mahmoudnazih/bldc-hardware/design/BLDC_4.kicad_sch

## KiCad design design/BLDC_4.kicad_sch (2024-09-17)

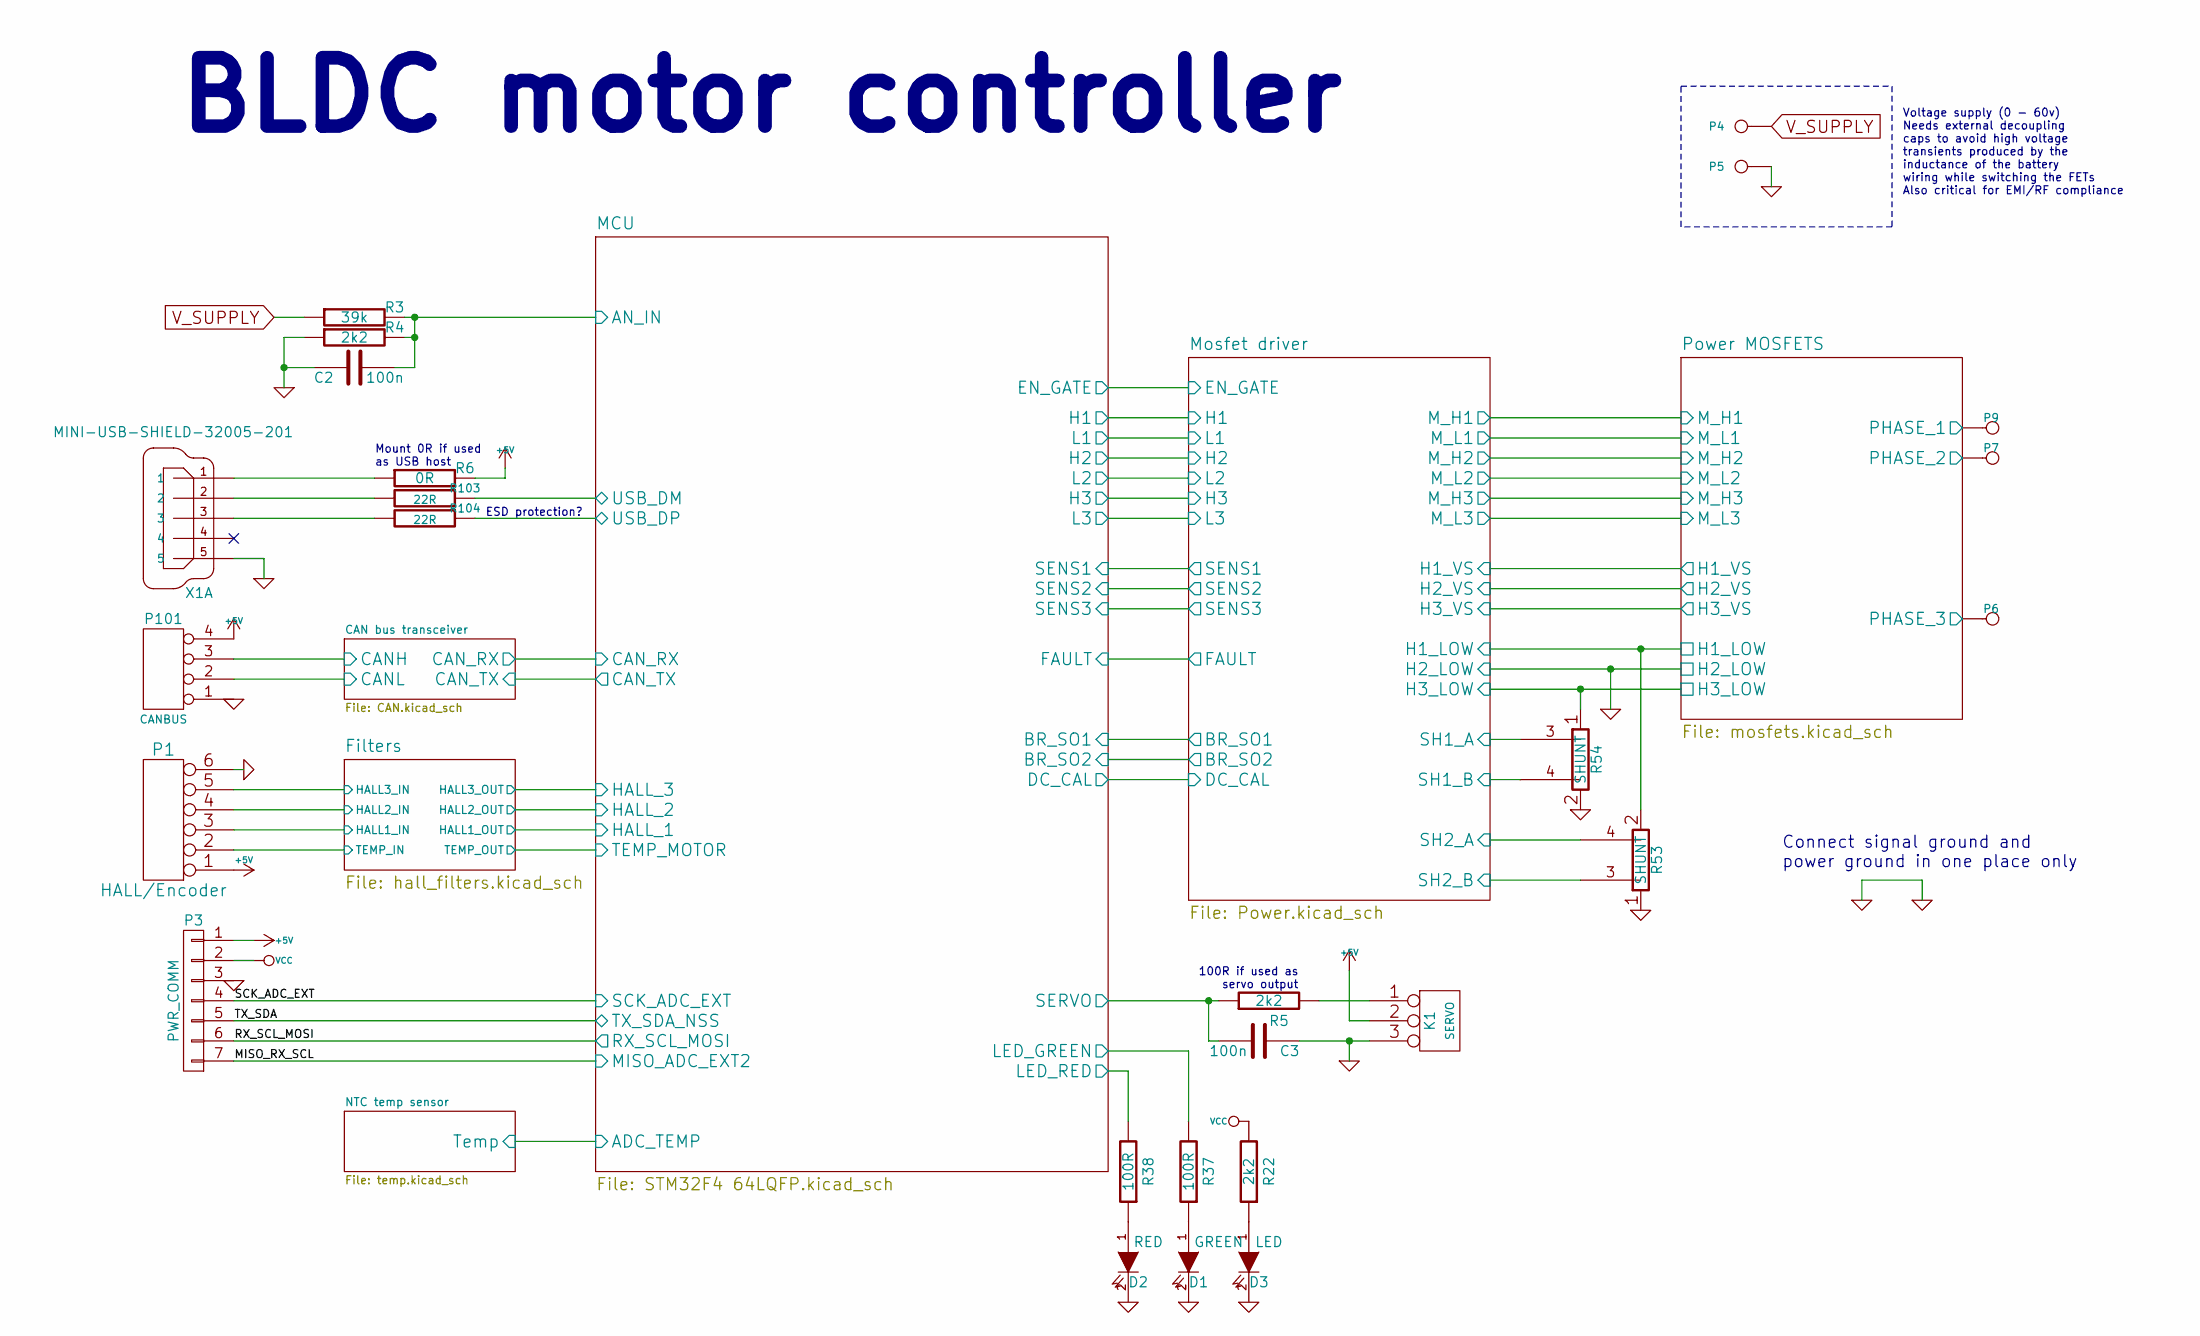
[picture p1: schematic BLDC_4.kicad_sch]

Parts:
C2, C3: 100n; SMD-0603_c
D1: GREEN; LED-0603
D2: RED; LED-0603
D3: LED; LED-0603
K1: SERVO; pinhead-1X03
P1: HALL/Encoder; MICRO_JST_6
P3: PWR_COMM; b7b-ph-kl
P4: IN+; 1PAD_4x5mm
P5: IN-; 1PAD_4x5mm
P6: MOTOR1; 1PAD_4x5mm
P7: MOTOR2; 1PAD_4x5mm
P9: MOTOR3; 1PAD_4x5mm
P101: CANBUS; b4b-ph-kl
R3: 39k; SMD-0603_r
R4, R5, R22: 2k2; SMD-0603_r
R6: 0R; SMD-0603_r
R37, R38: 100R; SMD-0603_r
R53, R54: SHUNT; WSLP2726
R103, R104: 22R; SMD-0603_r
X1: MINI-USB-SHIELD-32005-201; USB-UX60R-MB-5ST

Connections:
+5V: K1.2 (PM), P1.1, P3.1, P101.4, R6.2
AN_IN: C2.2, R3.2, R4.2
CANH: P101.3
CANL: P101.2
GND: C2.1, C3.1, D1.2 (K), D2.2 (K), D3.2 (K), K1.3, P1.6, P3.3, P5.1, P101.1, R4.1, R53.1, R54.2, X1.5
H1_LOW: R53.2
H3_LOW: R54.1
HALL1_IN: P1.3
HALL2_IN: P1.4
HALL3_IN: P1.5
LED_GREEN: R37.2
LED_RED: R38.2
MISO_RX_SCL: P3.7
unnamed: D1.1 (A), R37.1
unnamed: D2.1 (A), R38.1
unnamed: D3.1 (A), R22.1
unnamed: K1.1, R5.2
unnamed: R6.1, X1.1
unnamed: R103.2, X1.2
unnamed: R104.2, X1.3
PHASE_1: P9.1
PHASE_2: P7.1
PHASE_3: P6.1
RX_SCL_MOSI: P3.6
SCK_ADC_EXT: P3.4
SERVO: C3.2, R5.1
SH1_A: R54.3
SH1_B: R54.4
SH2_A: R53.4
SH2_B: R53.3
TEMP_IN: P1.2
TX_SDA: P3.5
USB_DM: R103.1
USB_DP: R104.1
VCC: P3.2, R22.2
V_SUPPLY: P4.1, R3.1

Notes on the sheet:
ESD protection?
Connect signal ground and power ground in one place only
Voltage supply (0 - 60v) Needs external decoupling caps to avoid high voltage transients produced by the inductance of the battery wiring while switching the FETs Also critical for EMI/RF compliance
BLDC motor controller
Mount 0R if used as USB host
100R if used as servo output
