mahmoudnazih/bldc-hardware/design/CAN.kicad_sch

## KiCad design design/CAN.kicad_sch (2024-09-17)

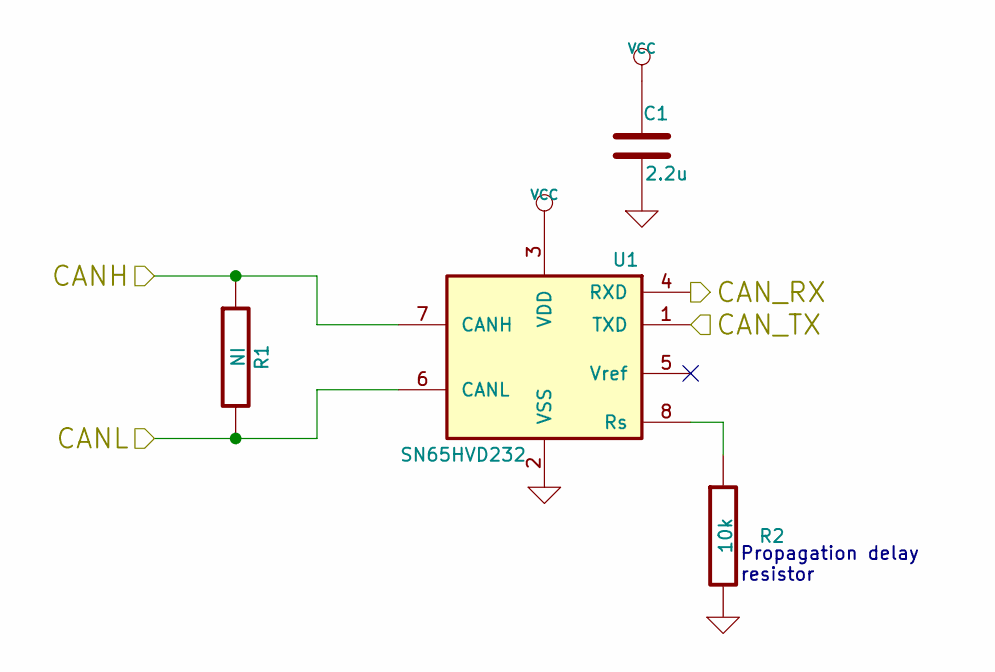
[picture p2: schematic CAN.kicad_sch]

Parts:
C1: 2.2u; SMD-0603_c
R1: NI; SMD-0603_r
R2: 10k; SMD-0603_r
U1: SN65HVD232; SOIC-8-W

Connections:
CANH: R1.1, U1.7 (CANH)
CANL: R1.2, U1.6 (CANL)
CAN_RX: U1.4 (RXD)
CAN_TX: U1.1 (TXD)
GND: C1.2, R2.2, U1.2 (VSS)
unnamed: R2.1, U1.8 (Rs)
VCC: C1.1, U1.3 (VDD)

Notes on the sheet:
Propagation delay resistor
