mahmoudnazih/bldc-hardware/design/Power.kicad_sch

## KiCad design design/Power.kicad_sch (2024-09-17)

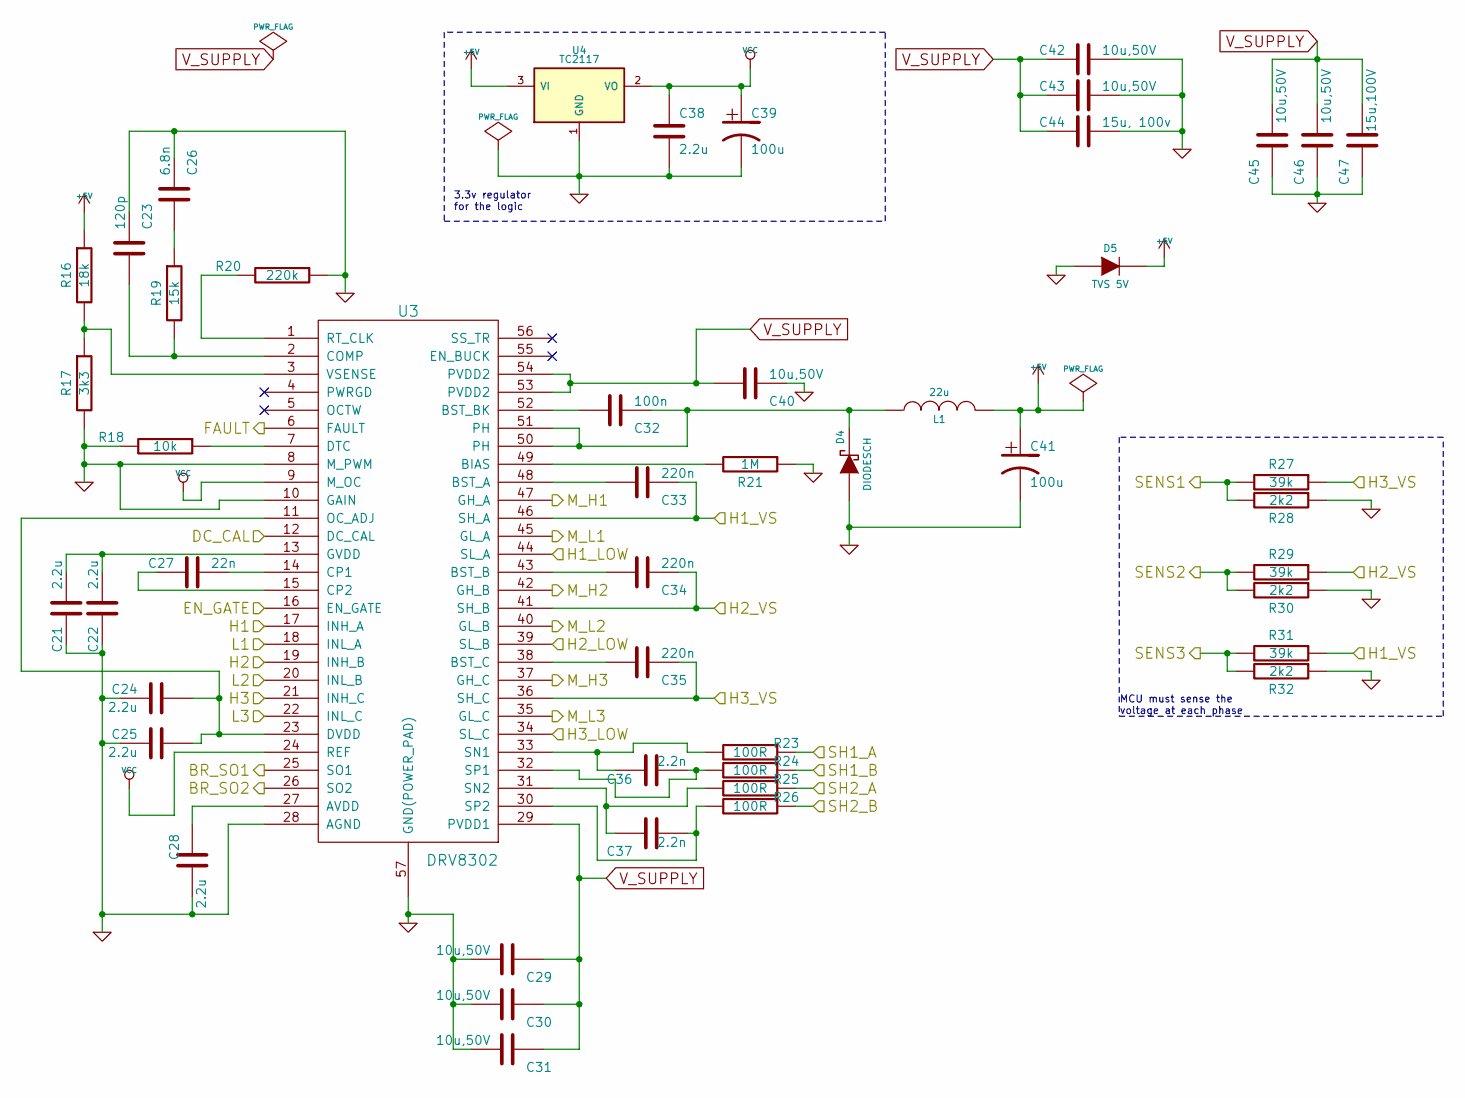
[picture p3: schematic Power.kicad_sch]

Parts:
C21, C22, C24, C25, C28, C38: 2.2u; SMD-0603_c
C23: 120p; SMD-0603_c
C26: 6.8n; SMD-0603_c
C27: 22n; SMD-0603_c
C29, C30, C31, C40, C42, C43, C45, C46: 10u,50V; SMD-1206
C32: 100n; SMD-0603_c
C33, C34, C35: 220n; SMD-0603_c
C36, C37: 2.2n; SMD-0603_c
C39, C41: 100u; c_tant_B
C44: 15u, 100v; c_2220
C47: 15u,100V; c_2220
D4: DIODESCH; SMA_Handsoldering
D5: TVS 5V; do214ac
L1: 22u; inductor_smd_8x5mm
R16: 18k; SMD-0603_r
R17: 3k3; SMD-0603_r
R18: 10k; SMD-0603_r
R19: 15k; SMD-0603_r
R20: 220k; SMD-0603_r
R21: 1M; SMD-0603_r
R23, R24, R25, R26: 100R; SMD-0603_r
R27, R29, R31: 39k; SMD-0603_r
R28, R30, R32: 2k2; SMD-0603_r
U3: DRV8302; TSSOP-56-PP
U4: TC2117; SOT-223

Connections:
+5V: C41.1, D5.2 (K), L1.2, R16.1, U4.3 (VI)
BR_SO1: U3.25 (SO1)
BR_SO2: U3.26 (SO2)
DC_CAL: U3.12 (DC_CAL)
EN_GATE: U3.16 (EN_GATE)
FAULT: U3.6 (FAULT)
GND: C21.2, C22.2, C23.1, C24.1, C25.1, C26.1, C28.1, C29.2, C30.2, C31.2, C38.2, C39.2, C40.1, C41.2, C42.1, C43.1, C44.1, C45.1, C46.1, C47.1, D4.1 (A), D5.1 (A), R17.2, R18.2, R20.1, R21.1, R28.1, R30.1, R32.1, U3.8 (M_PWM), U3.10 (GAIN), U3.28 (AGND), U3.57 (GND(POWER_PAD)), U4.1 (GND)
H1: U3.17 (INH_A)
H1_LOW: U3.44 (SL_A)
H1_VS: C33.1, R31.1, U3.46 (SH_A)
H2: U3.19 (INH_B)
H2_LOW: U3.39 (SL_B)
H2_VS: C34.1, R29.1, U3.41 (SH_B)
H3: U3.21 (INH_C)
H3_LOW: U3.34 (SL_C)
H3_VS: C35.1, R27.1, U3.36 (SH_C)
L1: U3.18 (INL_A)
L2: U3.20 (INL_B)
L3: U3.22 (INL_C)
M_H1: U3.47 (GH_A)
M_H2: U3.42 (GH_B)
M_H3: U3.37 (GH_C)
M_L1: U3.45 (GL_A)
M_L2: U3.40 (GL_B)
M_L3: U3.35 (GL_C)
unnamed: C21.1, C22.1, U3.13 (GVDD)
unnamed: C23.2, R19.2, U3.2 (COMP)
unnamed: C24.2, C25.2, U3.11 (OC_ADJ), U3.23 (DVDD)
unnamed: C26.2, R19.1
unnamed: C27.1, U3.14 (CP1)
unnamed: C27.2, U3.15 (CP2)
unnamed: C28.2, U3.27 (AVDD)
unnamed: C32.1, D4.2 (K), L1.1, U3.50 (PH), U3.51 (PH)
unnamed: C32.2, U3.52 (BST_BK)
unnamed: C33.2, U3.48 (BST_A)
unnamed: C34.2, U3.43 (BST_B)
unnamed: C35.2, U3.38 (BST_C)
unnamed: C36.1, R23.2, U3.33 (SN1)
unnamed: C36.2, R24.2, U3.32 (SP1)
unnamed: C37.1, R25.2, U3.31 (SN2)
unnamed: C37.2, R26.2, U3.30 (SP2)
unnamed: R16.2, R17.1, U3.3 (VSENSE)
unnamed: R18.1, U3.7 (DTC)
unnamed: R20.2, U3.1 (RT_CLK)
unnamed: R21.2, U3.49 (BIAS)
SENS1: R27.2, R28.2
SENS2: R29.2, R30.2
SENS3: R31.2, R32.2
SH1_A: R23.1
SH1_B: R24.1
SH2_A: R25.1
SH2_B: R26.1
VCC: C38.1, C39.1, U3.9 (M_OC), U3.24 (REF), U4.2 (VO)
V_SUPPLY: C29.1, C30.1, C31.1, C40.2, C42.2, C43.2, C44.2, C45.2, C46.2, C47.2, U3.29 (PVDD1), U3.53 (PVDD2), U3.54 (PVDD2)

Notes on the sheet:
3.3v regulator for the logic
MCU must sense the voltage at each phase
