mahmoudnazih/bldc-hardware/design/STM32F4 64LQFP.kicad_sch

## KiCad design design/STM32F4 64LQFP.kicad_sch (2024-09-17)

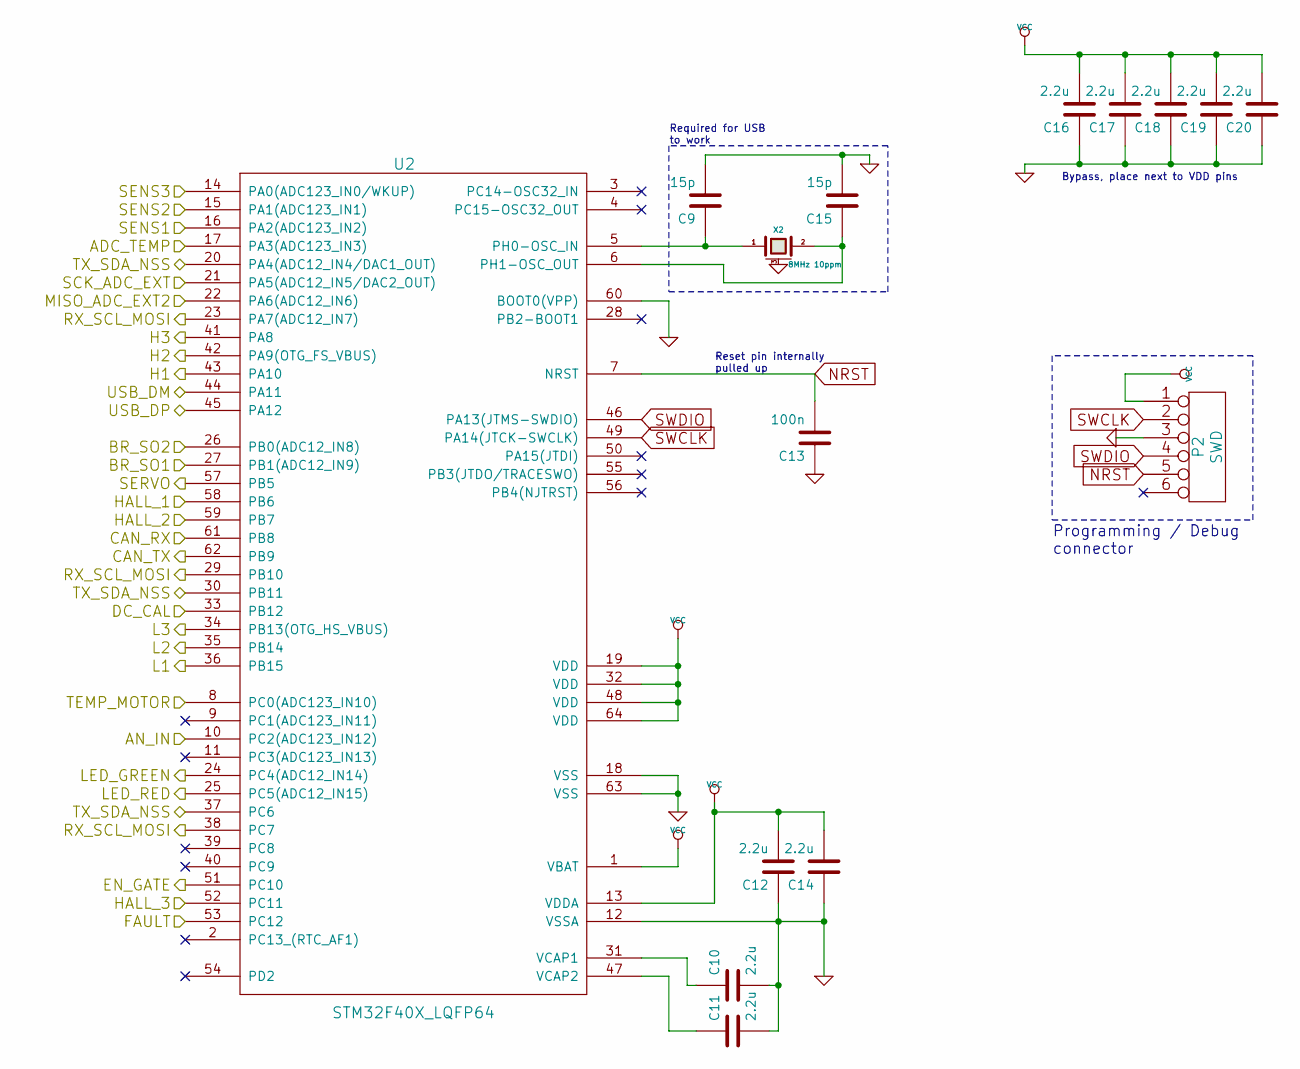
[picture p4: schematic STM32F4 64LQFP.kicad_sch]

Parts:
C9, C15: 15p; SMD-0603_c
C10, C11, C12, C14, C16, C17, C18, C19, C20: 2.2u; SMD-0603_c
C13: 100n; SMD-0603_c
P2: SWD; MICRO_JST_6
U2: STM32F40X_LQFP64; lqfp64_pad_mod
X2: 8MHz 10ppm; Crystal_5x3mm; mfg# ABM3B-8.0-10-1UT

Connections:
ADC_TEMP: U2.17 (PA3(ADC123_IN3))
AN_IN: U2.10 (PC2(ADC123_IN12))
BR_SO1: U2.27 (PB1(ADC12_IN9))
BR_SO2: U2.26 (PB0(ADC12_IN8))
CAN_RX: U2.61 (PB8)
CAN_TX: U2.62 (PB9)
DC_CAL: U2.33 (PB12)
EN_GATE: U2.51 (PC10)
FAULT: U2.53 (PC12)
GND: C9.2, C10.2, C11.2, C12.1, C13.1, C14.1, C15.2, C16.1, C17.1, C18.1, C19.1, C20.1, P2.3, U2.12 (VSSA), U2.18 (VSS), U2.60 (BOOT0(VPP)), U2.63 (VSS), X2.3 (case)
H1: U2.43 (PA10)
H2: U2.42 (PA9(OTG_FS_VBUS))
H3: U2.41 (PA8)
HALL_1: U2.58 (PB6)
HALL_2: U2.59 (PB7)
HALL_3: U2.52 (PC11)
L1: U2.36 (PB15)
L2: U2.35 (PB14)
L3: U2.34 (PB13(OTG_HS_VBUS))
LED_GREEN: U2.24 (PC4(ADC12_IN14))
LED_RED: U2.25 (PC5(ADC12_IN15))
MISO_ADC_EXT2: U2.22 (PA6(ADC12_IN6))
NRST: C13.2, P2.5, U2.7 (NRST)
unnamed: C9.1, U2.5 (PH0-OSC_IN), X2.1
unnamed: C10.1, U2.31 (VCAP1)
unnamed: C11.1, U2.47 (VCAP2)
unnamed: C15.1, U2.6 (PH1-OSC_OUT), X2.2
RX_SCL_MOSI: U2.23 (PA7(ADC12_IN7)), U2.29 (PB10), U2.38 (PC7)
SCK_ADC_EXT: U2.21 (PA5(ADC12_IN5/DAC2_OUT))
SENS1: U2.16 (PA2(ADC123_IN2))
SENS2: U2.15 (PA1(ADC123_IN1))
SENS3: U2.14 (PA0(ADC123_IN0/WKUP))
SERVO: U2.57 (PB5)
SWCLK: P2.2, U2.49 (PA14(JTCK-SWCLK))
SWDIO: P2.4, U2.46 (PA13(JTMS-SWDIO))
TEMP_MOTOR: U2.8 (PC0(ADC123_IN10))
TX_SDA_NSS: U2.20 (PA4(ADC12_IN4/DAC1_OUT)), U2.30 (PB11), U2.37 (PC6)
USB_DM: U2.44 (PA11)
USB_DP: U2.45 (PA12)
VCC: C12.2, C14.2, C16.2, C17.2, C18.2, C19.2, C20.2, P2.1, U2.1 (VBAT), U2.13 (VDDA), U2.19 (VDD), U2.32 (VDD), U2.48 (VDD), U2.64 (VDD)

Notes on the sheet:
Bypass, place next to VDD pins
Required for USB to work
Reset pin internally pulled up
Programming / Debug connector
