mahmoudnazih/bldc-hardware/design/hall_filters.kicad_sch

## KiCad design design/hall_filters.kicad_sch (2024-09-17)

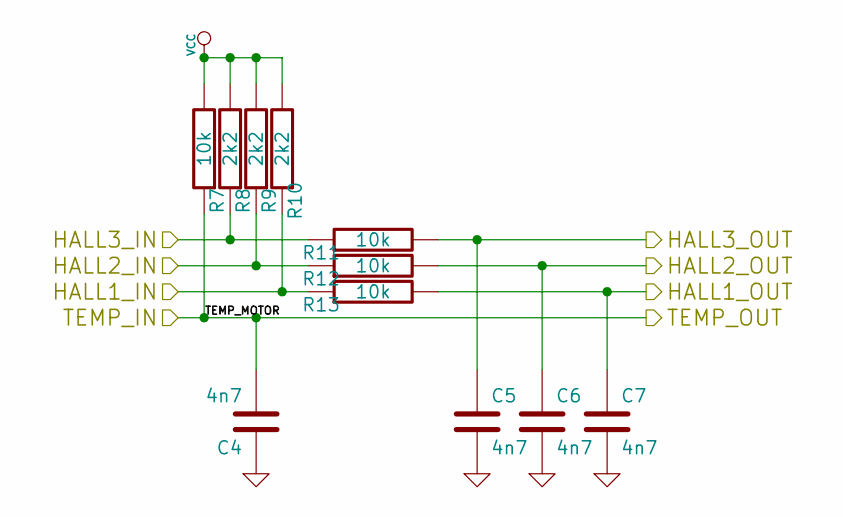
[picture p5: schematic hall_filters.kicad_sch]

Parts:
C4, C5, C6, C7: 4n7; SMD-0603_c
R7, R11, R12, R13: 10k; SMD-0603_r
R8, R9, R10: 2k2; SMD-0603_r

Connections:
GND: C4.1, C5.2, C6.2, C7.2
HALL1_IN: R10.1, R13.1
HALL1_OUT: C7.1, R13.2
HALL2_IN: R9.1, R12.1
HALL2_OUT: C6.1, R12.2
HALL3_IN: R8.1, R11.1
HALL3_OUT: C5.1, R11.2
TEMP_IN: C4.2, R7.1
VCC: R7.2, R8.2, R9.2, R10.2
