mahmoudnazih/bldc-hardware/design/mosfets.kicad_sch

## KiCad design design/mosfets.kicad_sch (2024-09-17)

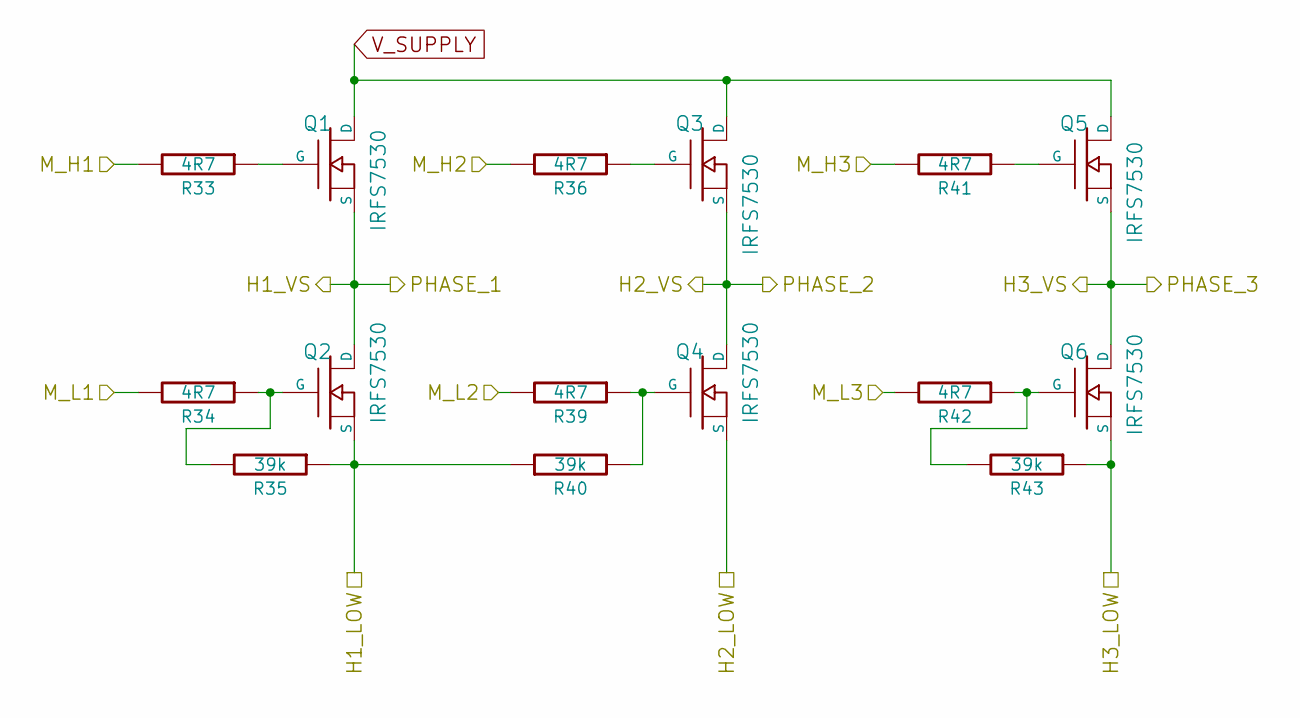
[picture p6: schematic mosfets.kicad_sch]

Parts:
Q1, Q2, Q3, Q4, Q5, Q6: IRFS7530; D2PAK-7-GDS
R33, R34, R36, R39, R41, R42: 4R7; SMD-0603_r
R35, R40, R43: 39k; SMD-0603_r

Connections:
H1_LOW: Q2.S, R35.1, R40.1
H1_VS: Q1.S, Q2.D
H2_LOW: Q4.S
H2_VS: Q3.S, Q4.D
H3_LOW: Q6.S, R43.1
H3_VS: Q5.S, Q6.D
M_H1: R33.2
M_H2: R36.2
M_H3: R41.2
M_L1: R34.2
M_L2: R39.2
M_L3: R42.2
unnamed: Q1.G, R33.1
unnamed: Q2.G, R34.1, R35.2
unnamed: Q3.G, R36.1
unnamed: Q4.G, R39.1, R40.2
unnamed: Q5.G, R41.1
unnamed: Q6.G, R42.1, R43.2
V_SUPPLY: Q1.D, Q3.D, Q5.D
