mahmoudnazih/bldc-hardware/design/temp.kicad_sch

## KiCad design design/temp.kicad_sch (2024-09-17)

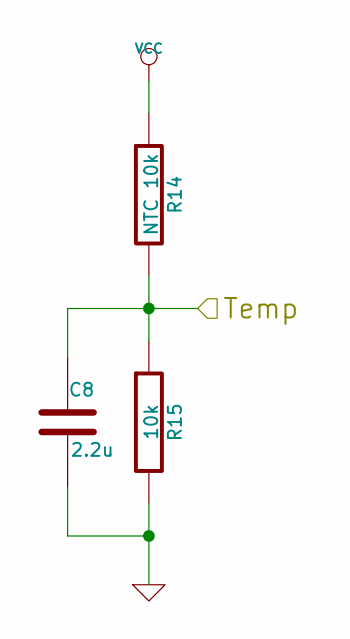
[picture p7: schematic temp.kicad_sch]

Parts:
C8: 2.2u; SMD-0603_c
R14: NTC 10k; SMD-0603_r
R15: 10k; SMD-0603_r

Connections:
GND: C8.2, R15.2
Temp: C8.1, R14.2, R15.1
VCC: R14.1
