mahmoudnazih/bldc-hardware/design/rescue-backup/Power-2024-09-17-04-46-35.sch

## KiCad design design/rescue-backup/Power-2024-09-17-04-46-35.sch (2024-09-17)

Schematic: Power-2024-09-17-04-46-35.sch

Parts:
C1, C8, C9, C39, C40, C43, C44, C49: 10u,50V; SMD-1206
C18, C20, C23, C24, C26, C52: 2.2u; SMD-0603_c
C19: 120p; SMD-0603_c
C21: 6.8n; SMD-0603_c
C22: 22n; SMD-0603_c
C25, C33: 100u; c_tant_B
C27: 100n; SMD-0603_c
C28, C29, C30: 220n; SMD-0603_c
C34, C36: 2.2n; SMD-0603_c
C37: 15u,100V; c_2220
C51: 15u, 100v; c_2220
D4: DIODESCH; SMA_Handsoldering
D5: TVS 5V; do214ac
L1: 22u; inductor_smd_8x5mm
R17: 18k; SMD-0603_r
R18: 3k3; SMD-0603_r
R19: 15k; SMD-0603_r
R20: 10k; SMD-0603_r
R21: 220k; SMD-0603_r
R23, R26, R32: 39k; SMD-0603_r
R24, R27, R33: 2k2; SMD-0603_r
R25: 1M; SMD-0603_r
R48, R49, R50, R51: 100R; SMD-0603_r
U2: TC2117; SOT-223
U3: DRV8302; TSSOP-56-PP

Notes on the sheet:
MCU must sense the voltage at each phase
3.3v regulator for the logic
