mahmoudnazih/bldc-hardware/design/rescue-backup/STM32F4 64LQFP-2024-09-17-04-46-35.sch

## KiCad design design/rescue-backup/STM32F4 64LQFP-2024-09-17-04-46-35.sch (2024-09-17)

Schematic: STM32F4 64LQFP-2024-09-17-04-46-35.sch

Parts:
C10, C11, C12, C13, C14, C16, C17, C31, C35: 2.2u; SMD-0603_c
C15, C38: 15p; SMD-0603_c
C32: 100n; SMD-0603_c
P2: SWD; MICRO_JST_6
U1: STM32F40X_LQFP64; lqfp64_pad_mod
X2: 8MHz 10ppm; Crystal_5x3mm; mfg# ABM3B-8.0-10-1UT

Notes on the sheet:
Programming / Debug connector
Reset pin internally pulled up
Required for USB to work
Bypass, place next to VDD pins
