mahmoudnazih/bldc-hardware/design/rescue-backup/hall_filters-2024-09-17-04-46-35.sch

## KiCad design design/rescue-backup/hall_filters-2024-09-17-04-46-35.sch (2024-09-17)

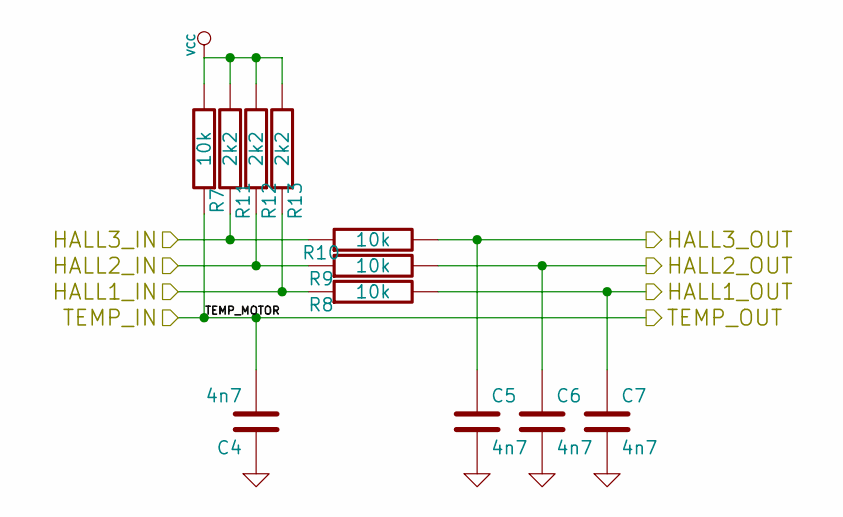
[picture p9: schematic hall_filters-2024-09-17-04-46-35.sch]

Parts:
C4, C5, C6, C7: 4n7; SMD-0603_c
R7, R8, R9, R10: 10k; SMD-0603_r
R11, R12, R13: 2k2; SMD-0603_r

Connections:
GND: C4.1, C5.2, C6.2, C7.2
HALL1_IN: R8.1, R13.1
HALL1_OUT: C7.1, R8.2
HALL2_IN: R9.1, R12.1
HALL2_OUT: C6.1, R9.2
HALL3_IN: R10.1, R11.1
HALL3_OUT: C5.1, R10.2
TEMP_IN: C4.2, R7.1
VCC: R7.2, R11.2, R12.2, R13.2
