mahmoudnazih/bldc-hardware/design/rescue-backup/mosfets-2024-09-17-04-46-35.sch

## KiCad design design/rescue-backup/mosfets-2024-09-17-04-46-35.sch (2024-09-17)


Parts:
Q1, Q2, Q3, Q4, Q5, Q6: IRFS7530; D2PAK-7-GDS
R28, R29, R34, R35, R42, R43: 4R7; SMD-0603_r
R30, R36, R46: 39k; SMD-0603_r

Connections:
H1_LOW: Q2.S, R30.1, R36.1
H1_VS: Q1.S, Q2.D
H2_LOW: Q4.S
H2_VS: Q3.S, Q4.D
H3_LOW: Q6.S, R46.1
H3_VS: Q5.S, Q6.D
M_H1: R28.2
M_H2: R34.2
M_H3: R42.2
M_L1: R29.2
M_L2: R35.2
M_L3: R43.2
unnamed: Q1.G, R28.1
unnamed: Q2.G, R29.1, R30.2
unnamed: Q3.G, R34.1
unnamed: Q4.G, R35.1, R36.2
unnamed: Q5.G, R42.1
unnamed: Q6.G, R43.1, R46.2
V_SUPPLY: Q1.D, Q3.D, Q5.D
