mahmoudnazih/bldc-hardware/design/rescue-backup/temp-2024-09-17-04-46-35.sch

## KiCad design design/rescue-backup/temp-2024-09-17-04-46-35.sch (2024-09-17)


Parts:
C41: 2.2u; SMD-0603_c
R1: NTC 10k; SMD-0603_r
R2: 10k; SMD-0603_r

Connections:
GND: C41.2, R2.2
Temp: C41.1, R1.2, R2.1
VCC: R1.1
